AntonioLJ7/Air-conditioning-controller-KiCad/README.md

Designing an air conditioning control with KiCad software

download
