AntonioLJ7/Air-conditioning-controller-KiCad/Air conditioning controler/PCB_Documentación/Librerias_proyecto/Libreria_3D_Ctrl_AA/CP_Elec_5x5.3.step

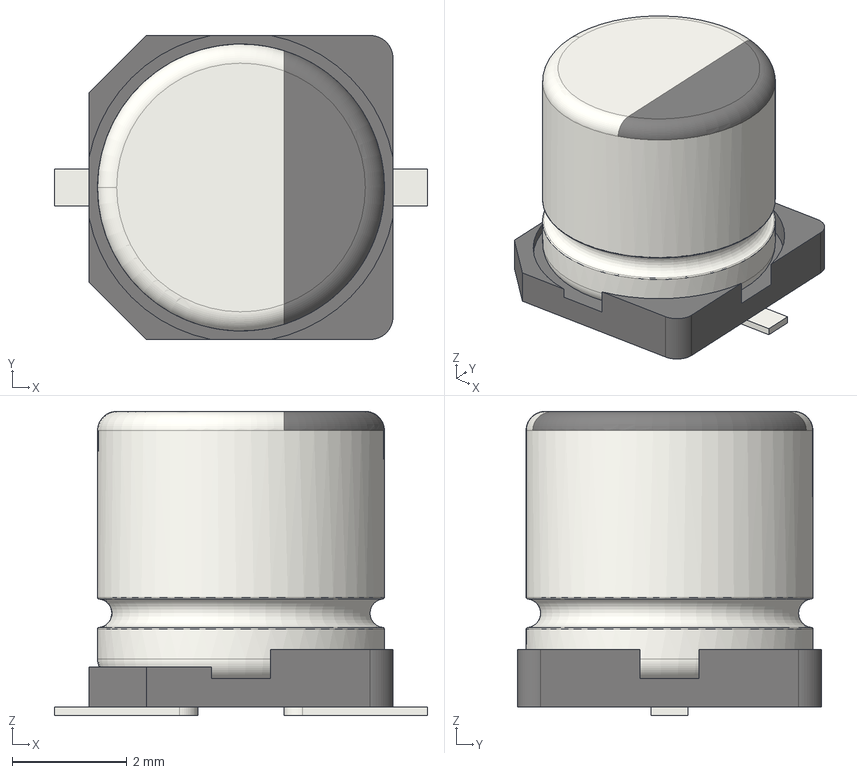
[picture p1: CAD file, 2024-07-14]
Air conditioning controler/PCB_Documentación/Librerias_proyecto/Libreria_3D_Ctrl_AA/CP_Elec_5x5.3.step
6.50 x 5.30 x 5.30 mm
