AntonioLJ7/Air-conditioning-controller-KiCad/Air conditioning controler/PCB_Documentación/Librerias_proyecto/Libreria_3D_Ctrl_AA/Fuentes_FreeCAD/NTCLE100E3221JB0_Pin_6mm.FCStd

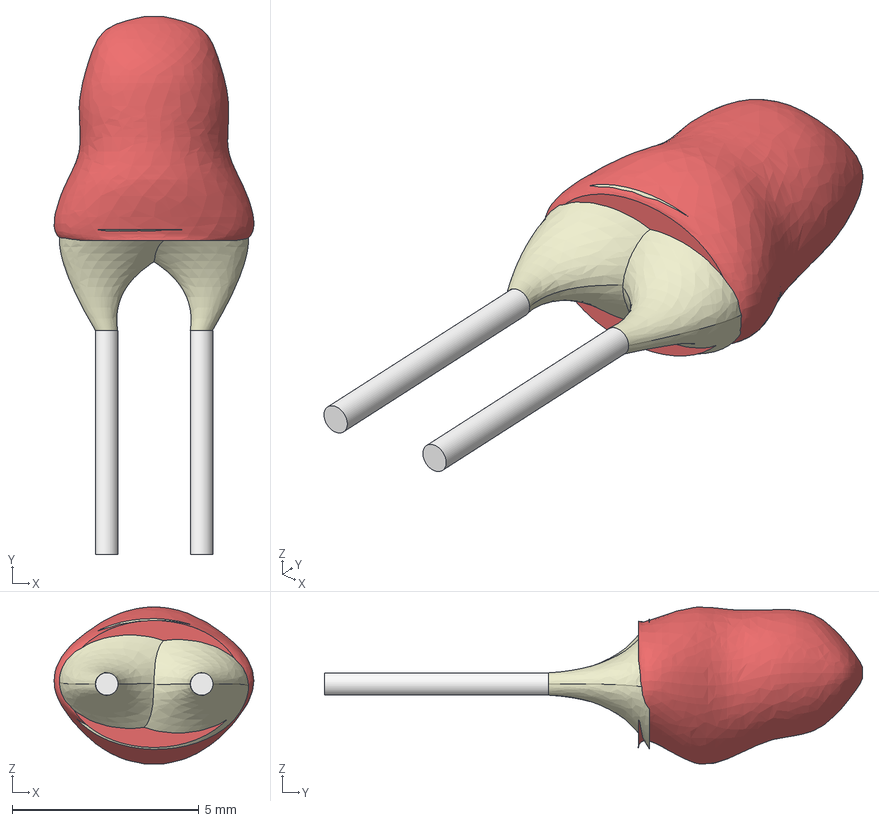
[picture p2: CAD file, 2024-07-14]
Air conditioning controler/PCB_Documentación/Librerias_proyecto/Libreria_3D_Ctrl_AA/Fuentes_FreeCAD/NTCLE100E3221JB0_Pin_6mm.FCStd
5.35 x 14.4 x 4.20 mm
Loft_Cuerpo
Loft_Pin
Loft_Pin001
