AntonioLJ7/Air-conditioning-controller-KiCad/Air conditioning controler/PCB_Documentación/Librerias_proyecto/Libreria_3D_Ctrl_AA/Crystal_SMD_MicroCrystal_MS3V-T1R.step

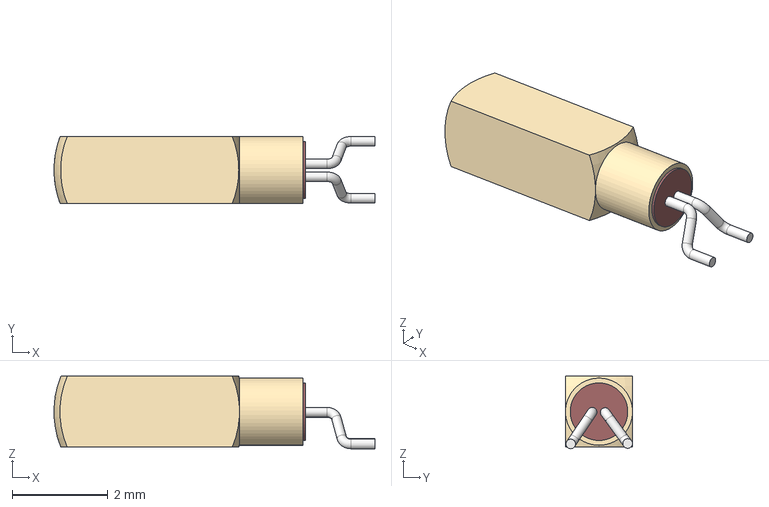
[picture p3: CAD file, 2024-07-14]
Air conditioning controler/PCB_Documentación/Librerias_proyecto/Libreria_3D_Ctrl_AA/Crystal_SMD_MicroCrystal_MS3V-T1R.step
6.70 x 1.40 x 1.51 mm
