AntonioLJ7/Air-conditioning-controller-KiCad/Air conditioning controler/PCB_Documentación/Librerias_proyecto/Libreria_3D_Ctrl_AA/Fuentes_FreeCAD/LCD_91-40698-110A0.FCStd

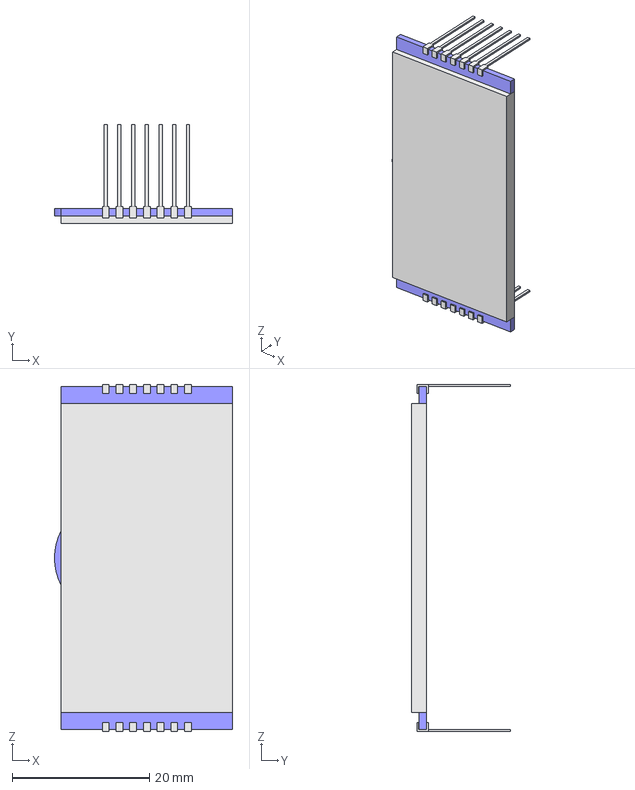
[picture p4: CAD file, 2024-07-14]
Air conditioning controler/PCB_Documentación/Librerias_proyecto/Libreria_3D_Ctrl_AA/Fuentes_FreeCAD/LCD_91-40698-110A0.FCStd
26.0 x 14.5 x 50.6 mm
Cuerpo_Ext
Cuerpo_Int
Pin
Pin001
Pin002
Pin003
Pin004
Pin005
Pin006
Pin007
Pin008
Pin009
Pin010
Pin011
Pin012
Pin013
