AntonioLJ7/Air-conditioning-controller-KiCad/Air conditioning controler/PCB_Documentación/Librerias_proyecto/Libreria_3D_Ctrl_AA/Fuentes_FreeCAD/NTCLE100E3221JB0.FCStd

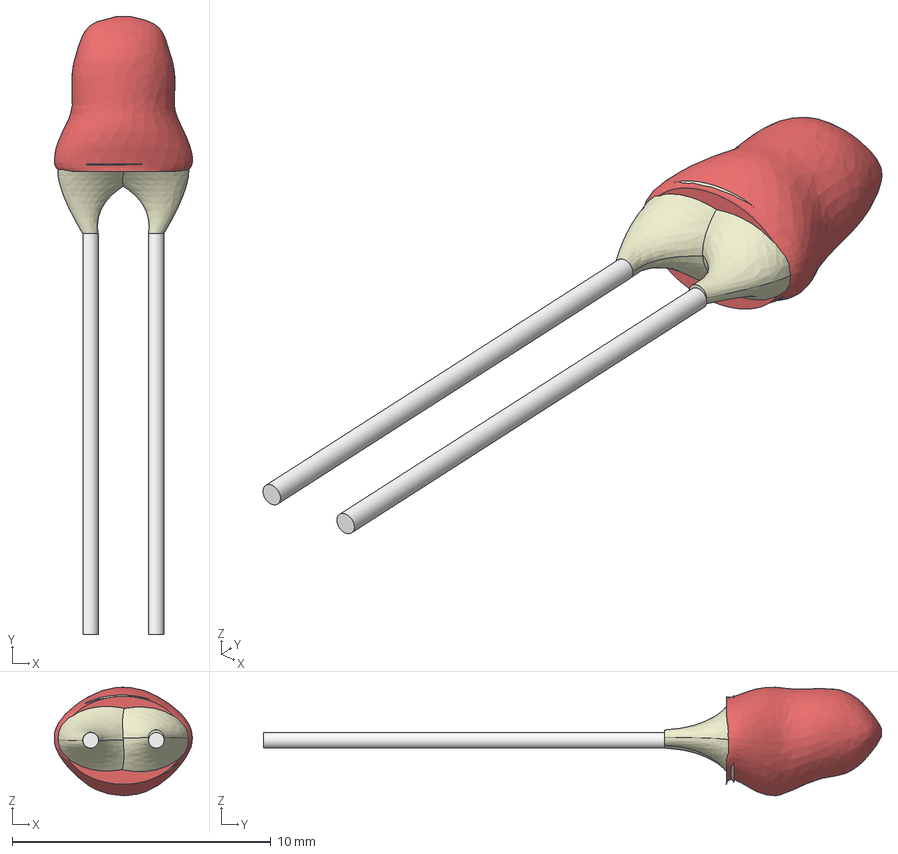
[picture p5: CAD file, 2024-07-14]
Air conditioning controler/PCB_Documentación/Librerias_proyecto/Libreria_3D_Ctrl_AA/Fuentes_FreeCAD/NTCLE100E3221JB0.FCStd
5.34 x 23.9 x 4.20 mm
Loft_Cuerpo
Loft_Pin
Loft_Pin001
