AntonioLJ7/Air-conditioning-controller-KiCad/Air conditioning controler/PCB_Documentación/Librerias_proyecto/Libreria_3D_Ctrl_AA/LED_D3.0mm_Horizontal_O1.27mm_Z2.0mm_IRGrey.step

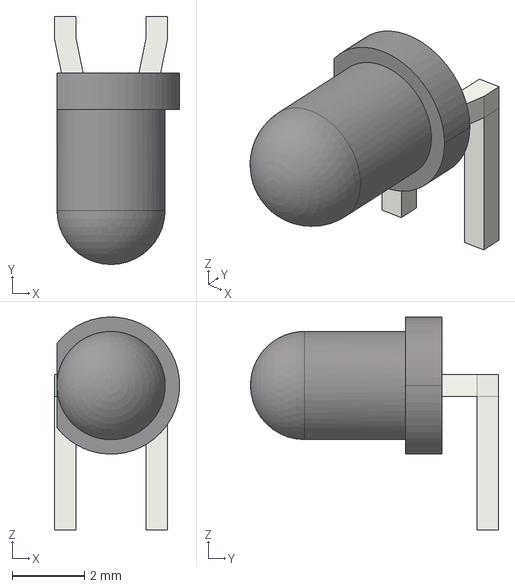
[picture p7: CAD file, 2024-07-14]
Air conditioning controler/PCB_Documentación/Librerias_proyecto/Libreria_3D_Ctrl_AA/LED_D3.0mm_Horizontal_O1.27mm_Z2.0mm_IRGrey.step
3.47 x 6.87 x 5.90 mm
