AntonioLJ7/Air-conditioning-controller-KiCad/Air conditioning controler/PCB_Documentación/Librerias_proyecto/Libreria_3D_Ctrl_AA/IDC-Header_2x07_P2.54mm_Vertical.step

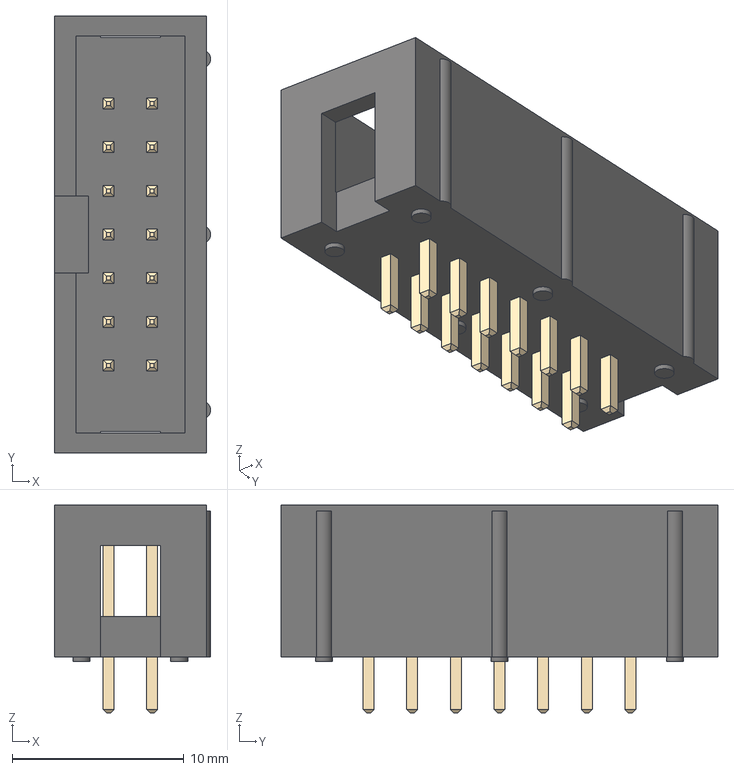
[picture p8: CAD file, 2024-07-14]
Air conditioning controler/PCB_Documentación/Librerias_proyecto/Libreria_3D_Ctrl_AA/IDC-Header_2x07_P2.54mm_Vertical.step
9.10 x 25.4 x 12.1 mm
