AntonioLJ7/Air-conditioning-controller-KiCad/Air conditioning controler/PCB_Documentación/Librerias_proyecto/Libreria_3D_Ctrl_AA/TQFP-64_10x10mm_P0.5mm.step

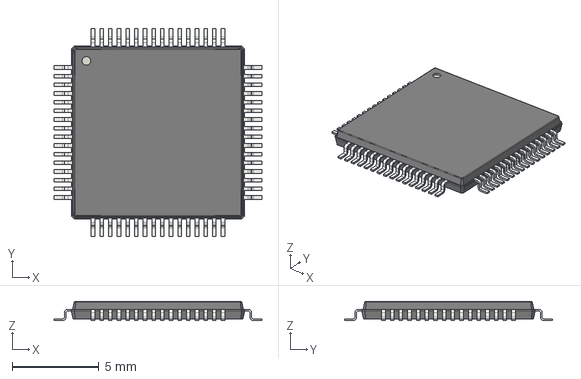
[picture p13: CAD file, 2024-07-14]
Air conditioning controler/PCB_Documentación/Librerias_proyecto/Libreria_3D_Ctrl_AA/TQFP-64_10x10mm_P0.5mm.step
12.0 x 12.0 x 1.10 mm
