AntonioLJ7/Air-conditioning-controller-KiCad/Air conditioning controler/PCB_Documentación/Librerias_proyecto/Libreria_3D_Ctrl_AA/Molex_PicoBlade_53261-0671_1x06-1MP_P1.25mm_Horizontal.step

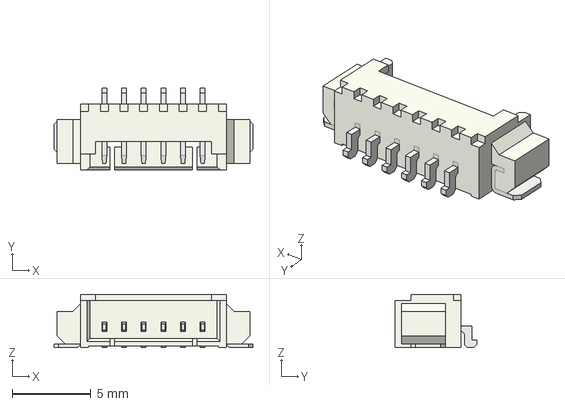
[picture p14: CAD file, 2024-07-14]
Air conditioning controler/PCB_Documentación/Librerias_proyecto/Libreria_3D_Ctrl_AA/Molex_PicoBlade_53261-0671_1x06-1MP_P1.25mm_Horizontal.step
12.7 x 5.20 x 3.40 mm
