AntonioLJ7/Air-conditioning-controller-KiCad/(list of files, cad)

Other CAD files:
Air conditioning controler/PCB_Documentación/Librerias_proyecto/Libreria_3D_Ctrl_AA/Fuentes_FreeCAD/Cristal_MS3V-T1R.FCStd
Air conditioning controler/PCB_Documentación/Librerias_proyecto/Libreria_3D_Ctrl_AA/NTCLE100E3221JB0_Pin_6mm.step
Air conditioning controler/PCB_Documentación/Librerias_proyecto/Libreria_3D_Ctrl_AA/NTCLE100E3221JB0.step
