AntonioLJ7/Air-conditioning-controller-KiCad/Air conditioning controler/Ctrl_AA/Ficheros_fab_Ctrl_AA/Ctrl_AA-B_Paste.pdf

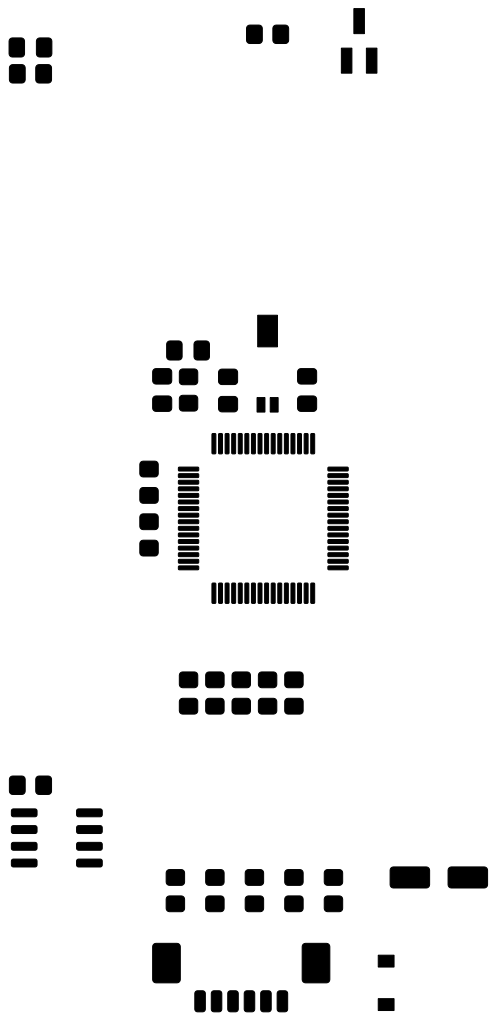
[picture p19: page 1]
