AntonioLJ7/Air-conditioning-controller-KiCad/Air conditioning controler/Ctrl_AA/Ficheros_fab_Ctrl_AA/Ctrl_AA-F_Cu.pdf

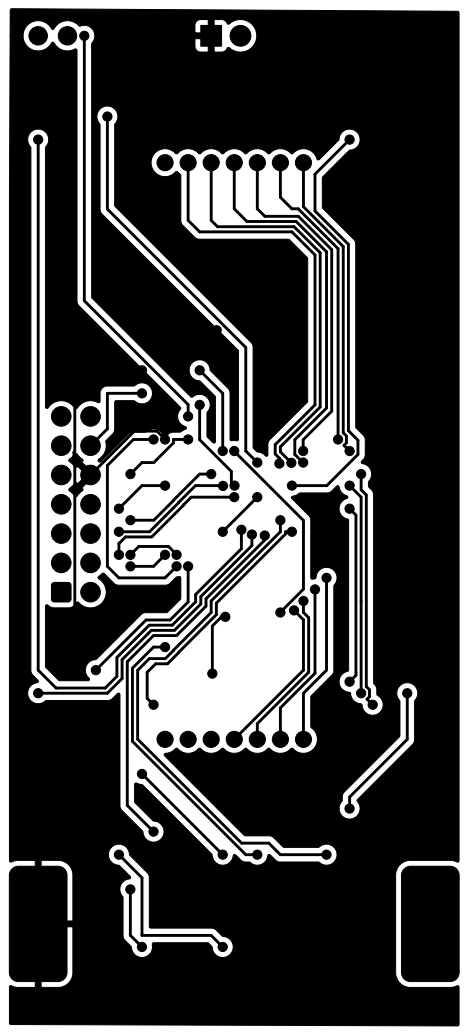
[picture p21: page 1]
