AntonioLJ7/Air-conditioning-controller-KiCad/Air conditioning controler/Ctrl_AA/Ctrl_AA.kicad_pcb

## KiCad design Air conditioning controler/Ctrl_AA/Ctrl_AA.kicad_pcb (2024-07-14)

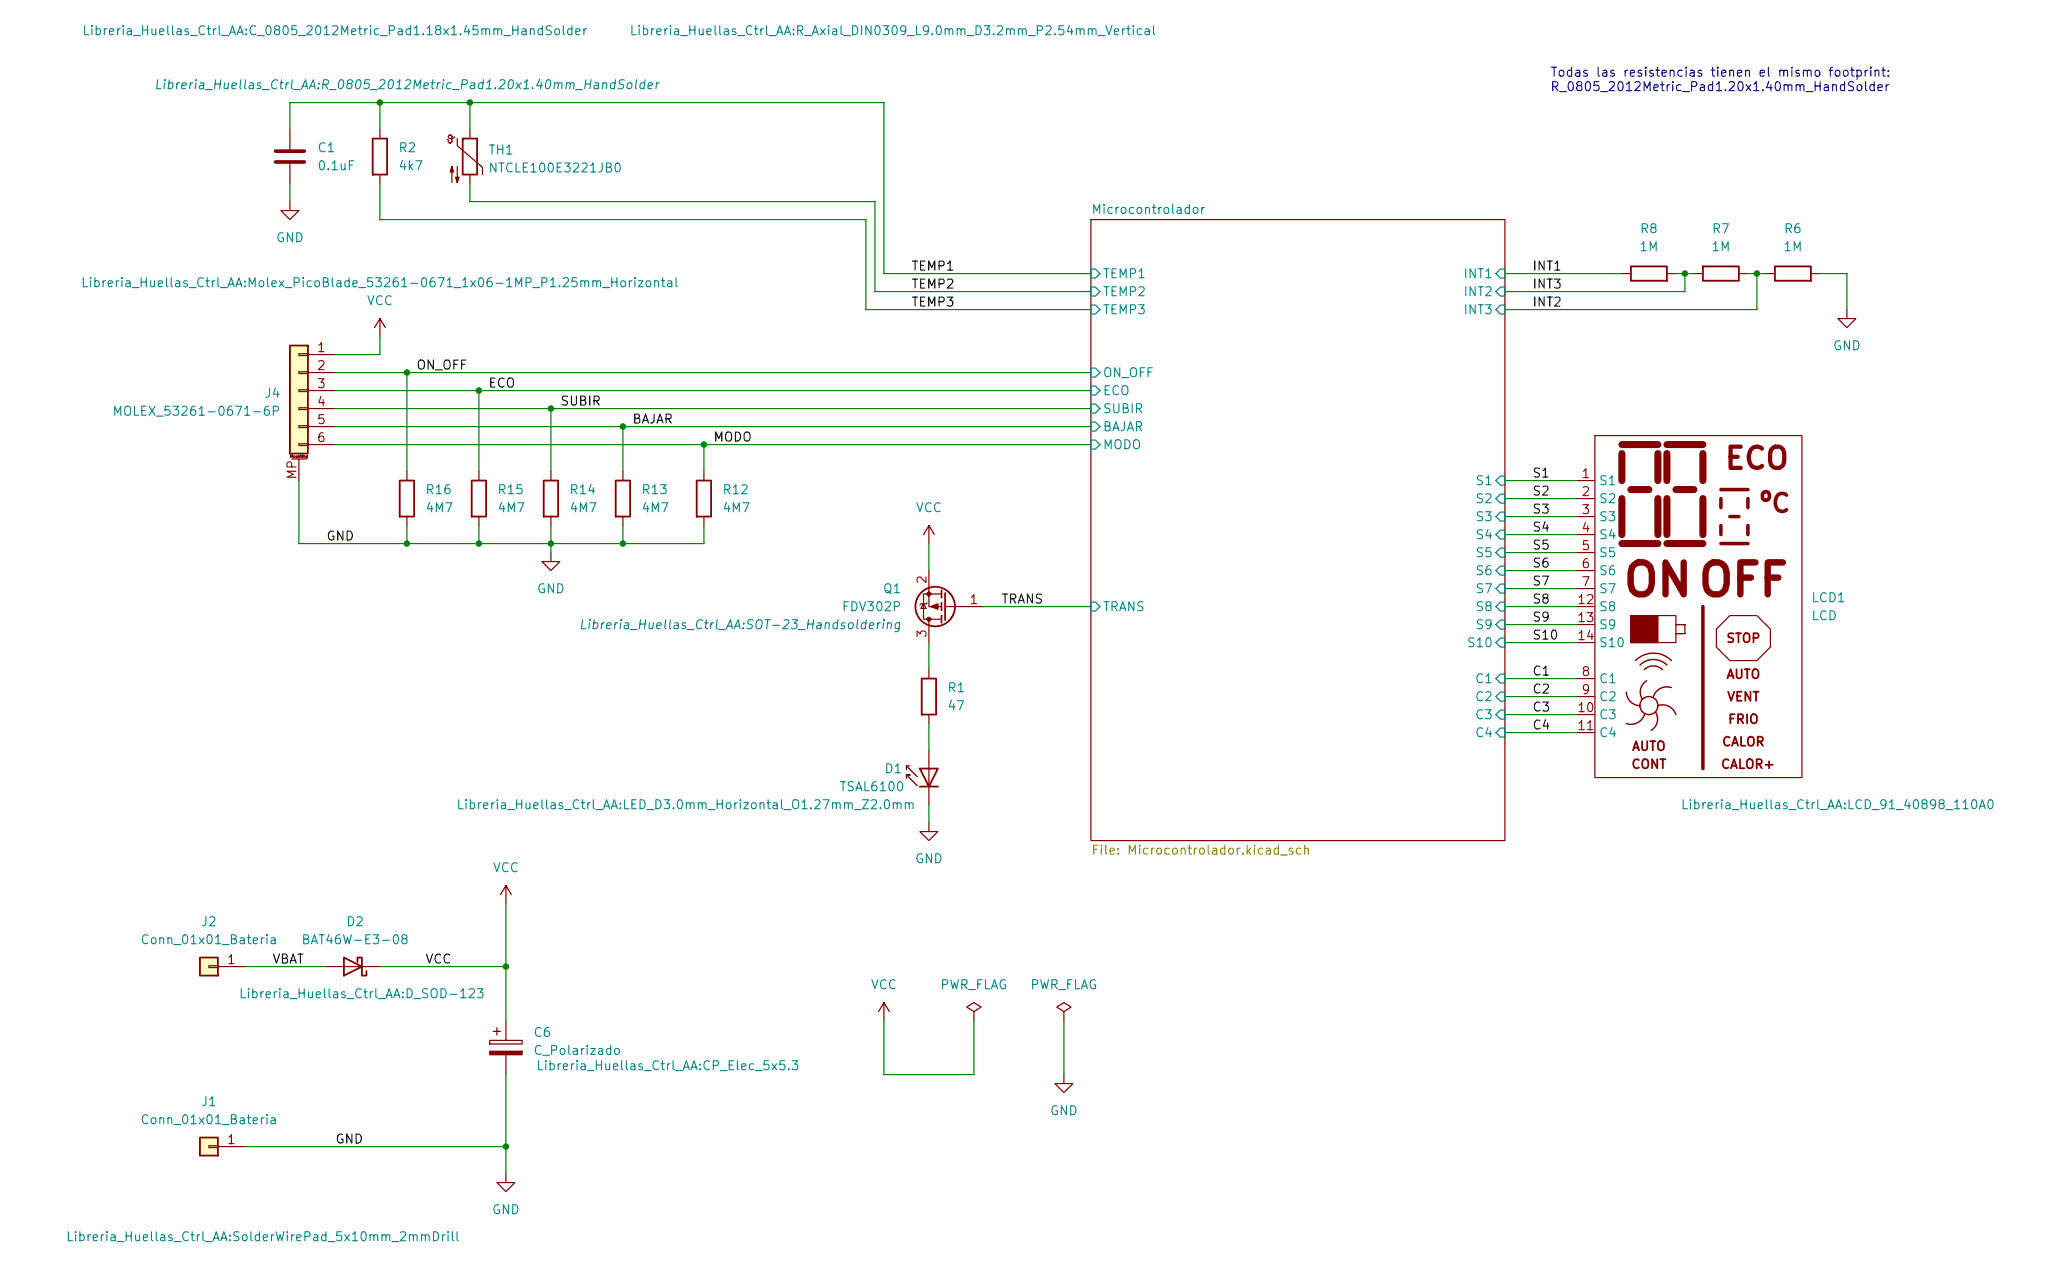
[picture p24: schematic Ctrl_AA.kicad_sch, Controlador de Aire Acondicionado (Ctrl A/A)]

Parts:
C1: 0.1uF; C_0805_2012Metric_Pad1.18x1.45mm_HandSolder
C6: C_Polarizado; CP_Elec_5x5.3
D1: TSAL6100; LED_D3.0mm_Horizontal_O1.27mm_Z2.0mm
D2: BAT46W-E3-08; D_SOD-123
J1, J2: Conn_01x01_Bateria; SolderWirePad_5x10mm_2mmDrill
J4: MOLEX_53261-0671-6P; Molex_PicoBlade_53261-0671_1x06-1MP_P1.25mm_Horizontal
LCD1: LCD; LCD_91_40898_110A0
Q1: FDV302P; SOT-23_Handsoldering
R1: 47; R_0805_2012Metric_Pad1.20x1.40mm_HandSolder
R2: 4k7; R_0805_2012Metric_Pad1.20x1.40mm_HandSolder
R6, R7, R8: 1M; R_0805_2012Metric_Pad1.20x1.40mm_HandSolder
R12, R13, R14, R15, R16: 4M7; R_0805_2012Metric_Pad1.20x1.40mm_HandSolder
TH1: NTCLE100E3221JB0; R_Axial_DIN0309_L9.0mm_D3.2mm_P2.54mm_Vertical

Connections:
/BAJAR: J4.5, R13.1; also elsewhere on the board
/C1: LCD1.8 (C1); also elsewhere on the board
/C2: LCD1.9 (C2); also elsewhere on the board
/C3: LCD1.10 (C3); also elsewhere on the board
/C4: LCD1.11 (C4); also elsewhere on the board
/ECO: J4.3, R15.1; also elsewhere on the board
/INT1: R8.1; also elsewhere on the board
/INT2: R6.1, R7.1; also elsewhere on the board
/INT3: R7.2, R8.2; also elsewhere on the board
/MODO: J4.6, R12.1; also elsewhere on the board
/ON_OFF: J4.2, R16.1; also elsewhere on the board
/S1: LCD1.1 (S1); also elsewhere on the board
/S2: LCD1.2 (S2); also elsewhere on the board
/S3: LCD1.3 (S3); also elsewhere on the board
/S4: LCD1.4 (S4); also elsewhere on the board
/S5: LCD1.5 (S5); also elsewhere on the board
/S6: LCD1.6 (S6); also elsewhere on the board
/S7: LCD1.7 (S7); also elsewhere on the board
/S8: LCD1.12 (S8); also elsewhere on the board
/S9: LCD1.13 (S9); also elsewhere on the board
/S10: LCD1.14 (S10); also elsewhere on the board
/SUBIR: J4.4, R14.1; also elsewhere on the board
/TEMP1: C1.1, R2.1, TH1.1; also elsewhere on the board
/TEMP2: TH1.2; also elsewhere on the board
/TEMP3: R2.2; also elsewhere on the board
/TRANS: Q1.1 (G); also elsewhere on the board
/VBAT: D2.2 (A), J2.1
GND: C1.2, C6.2, D1.1 (K), J1.1, J4.MP (MountPin), R6.2, R12.2, R13.2, R14.2, R15.2, R16.2; also elsewhere on the board
unnamed: D1.2 (A), R1.2
unnamed: Q1.3 (D), R1.1
VCC: C6.1, D2.1 (K), J4.1, Q1.2 (S); also elsewhere on the board

Notes on the sheet:
Todas las resistencias tienen el mismo footprint: R_0805_2012Metric_Pad1.20x1.40mm_HandSolder

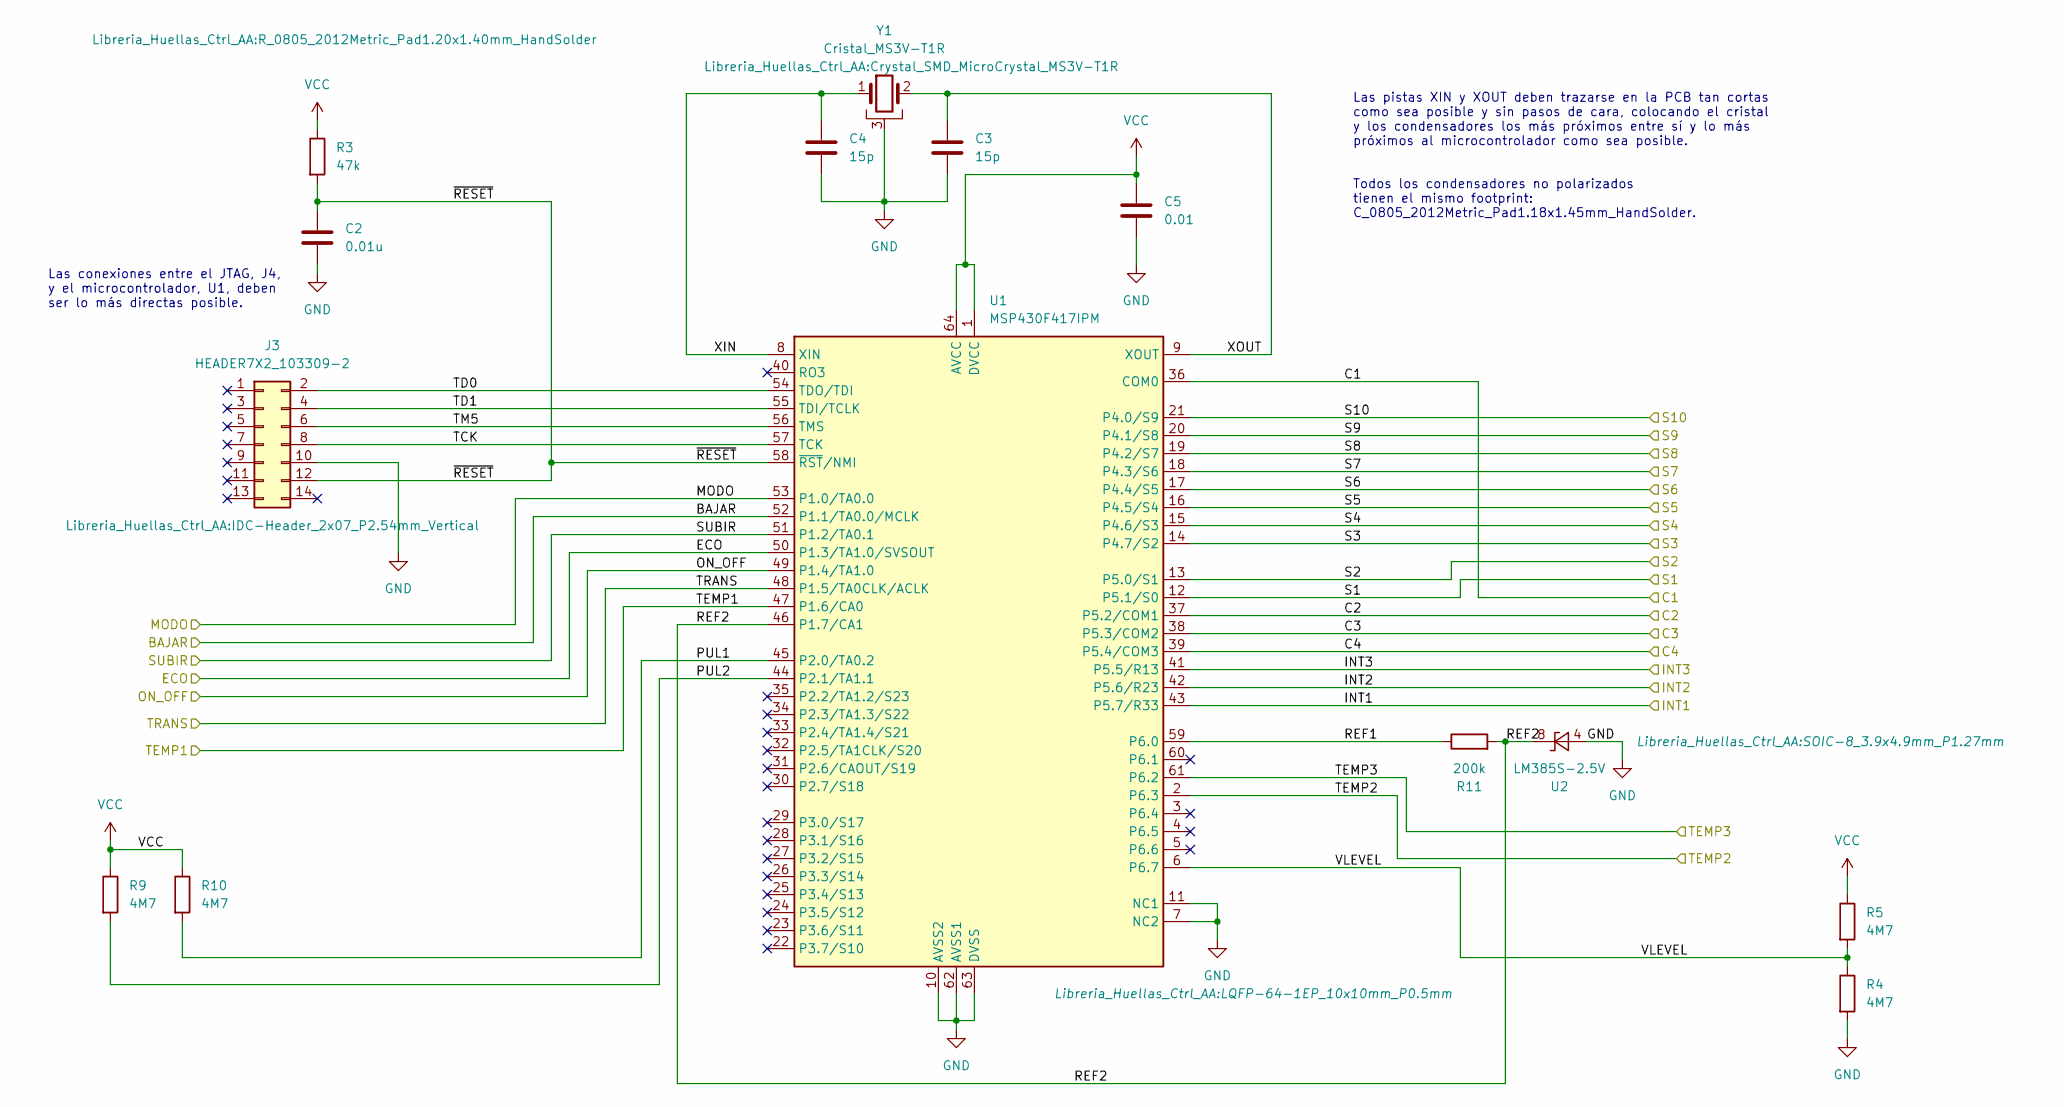
[picture p25: schematic Microcontrolador.kicad_sch, Controlador de Aire Acondicionado (Ctrl A/A)]

Parts:
C2: 0.01u; C_0805_2012Metric_Pad1.18x1.45mm_HandSolder
C3, C4: 15p; C_0805_2012Metric_Pad1.18x1.45mm_HandSolder
C5: 0.01; C_0805_2012Metric_Pad1.18x1.45mm_HandSolder
J3: HEADER7X2_103309-2; IDC-Header_2x07_P2.54mm_Vertical
R3: 47k; R_0805_2012Metric_Pad1.20x1.40mm_HandSolder
R4, R5, R9, R10: 4M7; R_0805_2012Metric_Pad1.20x1.40mm_HandSolder
R11: 200k; R_0805_2012Metric_Pad1.20x1.40mm_HandSolder
U1: MSP430F417IPM; LQFP-64-1EP_10x10mm_P0.5mm
U2: LM385S-2.5V; SOIC-8_3.9x4.9mm_P1.27mm
Y1: Cristal_MS3V-T1R; Crystal_SMD_MicroCrystal_MS3V-T1R

Connections:
/BAJAR: U1.52 (P1.1/TA0.0/MCLK); also elsewhere on the board
/C1: U1.36 (COM0); also elsewhere on the board
/C2: U1.37 (P5.2/COM1); also elsewhere on the board
/C3: U1.38 (P5.3/COM2); also elsewhere on the board
/C4: U1.39 (P5.4/COM3); also elsewhere on the board
/ECO: U1.50 (P1.3/TA1.0/SVSOUT); also elsewhere on the board
/INT1: U1.43 (P5.7/R33); also elsewhere on the board
/INT2: U1.41 (P5.5/R13); also elsewhere on the board
/INT3: U1.42 (P5.6/R23); also elsewhere on the board
/MODO: U1.53 (P1.0/TA0.0); also elsewhere on the board
/Microcontrolador/PUL1: R10.2, U1.45 (P2.0/TA0.2)
/Microcontrolador/PUL2: R9.2, U1.44 (P2.1/TA1.1)
/Microcontrolador/REF1: R11.1, U1.59 (P6.0)
/Microcontrolador/REF2: R11.2, U1.46 (P1.7/CA1), U2.6 (K), U2.8 (K)
/Microcontrolador/TCK: J3.8, U1.57 (TCK)
/Microcontrolador/TD0: J3.2, U1.54 (TDO/TDI)
/Microcontrolador/TD1: J3.4, U1.55 (TDI/TCLK)
/Microcontrolador/TM5: J3.6, U1.56 (TMS)
/Microcontrolador/VLEVEL: R4.1, R5.2, U1.6 (P6.7)
/Microcontrolador/XIN: C4.1, U1.8 (XIN), Y1.1
/Microcontrolador/XOUT: C3.1, U1.9 (XOUT), Y1.2
/Microcontrolador/~RESET: C2.1, J3.12, R3.2, U1.58 (~RST/NMI)
/ON_OFF: U1.49 (P1.4/TA1.0); also elsewhere on the board
/S1: U1.12 (P5.1/S0); also elsewhere on the board
/S2: U1.13 (P5.0/S1); also elsewhere on the board
/S3: U1.14 (P4.7/S2); also elsewhere on the board
/S4: U1.15 (P4.6/S3); also elsewhere on the board
/S5: U1.16 (P4.5/S4); also elsewhere on the board
/S6: U1.17 (P4.4/S5); also elsewhere on the board
/S7: U1.18 (P4.3/S6); also elsewhere on the board
/S8: U1.19 (P4.2/S7); also elsewhere on the board
/S9: U1.20 (P4.1/S8); also elsewhere on the board
/S10: U1.21 (P4.0/S9); also elsewhere on the board
/SUBIR: U1.51 (P1.2/TA0.1); also elsewhere on the board
/TEMP1: U1.47 (P1.6/CA0); also elsewhere on the board
/TEMP2: U1.2 (P6.3); also elsewhere on the board
/TEMP3: U1.61 (P6.2); also elsewhere on the board
/TRANS: U1.48 (P1.5/TA0CLK/ACLK); also elsewhere on the board
GND: C2.2, C3.2, C4.2, C5.2, J3.10, R4.2, U1.7 (NC2), U1.10 (AVSS2), U1.11 (NC1), U1.62 (AVSS1), U1.63 (DVSS), U2.4 (A), Y1.3; also elsewhere on the board
VCC: C5.1, R3.1, R5.1, R9.1, R10.1, U1.1 (DVCC), U1.64 (AVCC); also elsewhere on the board

Notes on the sheet:
Las pistas XIN y XOUT deben trazarse en la PCB tan cortas como sea posible y sin pasos de cara, colocando el cristal y los condensadores los más próximos entre sí y lo más próximos al microcontrolador como sea posible.
Todos los condensadores no polarizados tienen el mismo footprint: C_0805_2012Metric_Pad1.18x1.45mm_HandSolder.
Las conexiones entre el JTAG, J4, y el microcontrolador, U1, deben ser lo más directas posible.

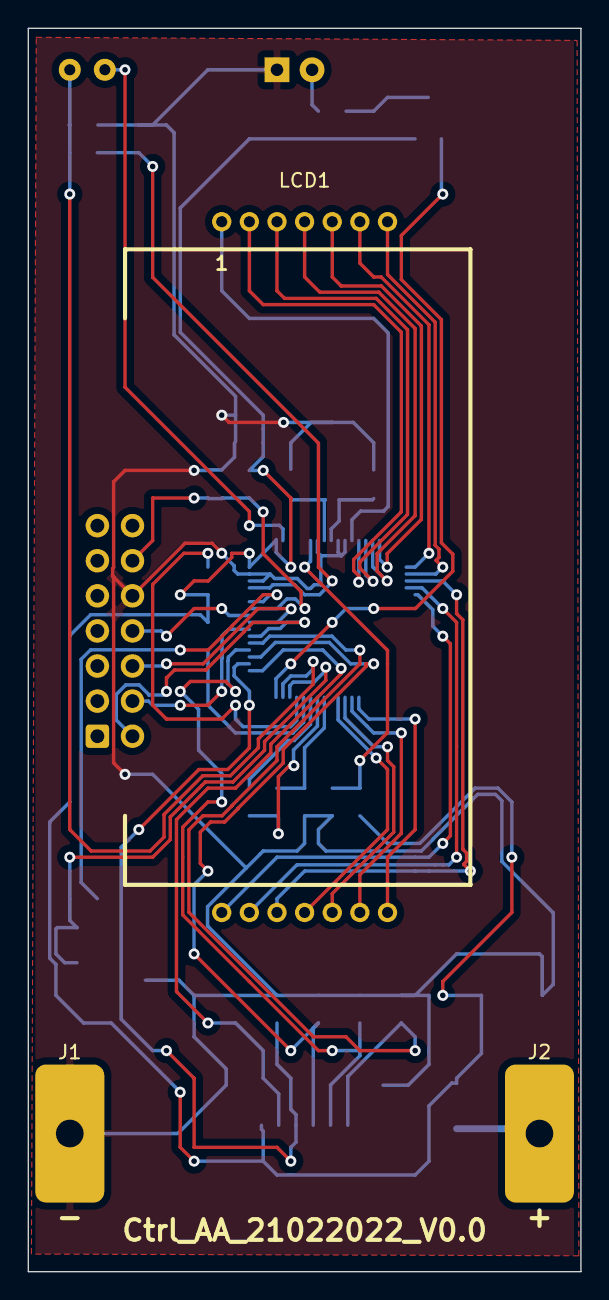
[picture p26: board Ctrl_AA.kicad_pcb from above]

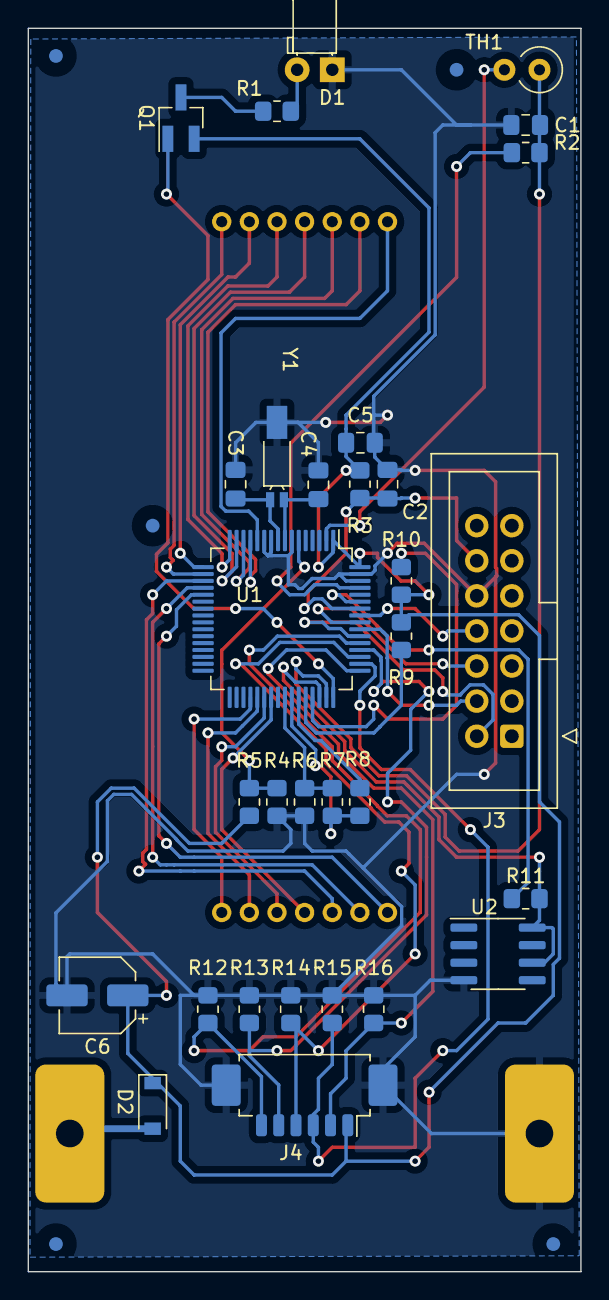
[picture p27: board Ctrl_AA.kicad_pcb from below]

Board: 2 copper layers, 40.0 x 90.0 mm, 34 parts (31 on the bottom side), 43 nets.
