AntonioLJ7/Air-conditioning-controller-KiCad/(notices)

Notices in the files:
Air conditioning controler/PCB_Documentación/Librerias_proyecto/Libreria_3D_Ctrl_AA/SOT-23.step:
Copyright (C) 2017, kicad StepUp
This work is licensed under the [Creative Commons CC-BY-SA 4.0 License](https://creativecommons.org/licenses/by-sa/4.0/legalcode),
with the following exception:
To the extent that the creation of electronic designs that use 'Licensed Material' can be considered to be 'Adapted Material',
You are free to use the library data in your own projects without the obligation to share your project files under this or any other license agreement.
Air conditioning controler/PCB_Documentación/Librerias_proyecto/Libreria_3D_Ctrl_AA/CP_Elec_5x5.3.step:
Copyright (C) 2018, kicad StepUp
Air conditioning controler/PCB_Documentación/Librerias_proyecto/Libreria_3D_Ctrl_AA/Molex_PicoBlade_53261-0671_1x06-1MP_P1.25mm_Horizontal.step:
Copyright (C) 2018, Rene Poeschl
